mumford/ReverseGeocache/(list of files, drawings)

Other design files:
Reverse Geocache.fzz
